Fihdi/QPOL/QPOL-B-Board-BOM.csv

Reference | Qty | Value | Footprint
C2,C3,C9,C10,C14 | 5 | 1n | Capacitor_SMD:C_0805_2012Metric
C6,C11,C12,C13,C15,C16 | 6 | 100n | Capacitor_SMD:C_0805_2012Metric
C7,C8,C17 | 3 | 1u | Capacitor_SMD:C_0805_2012Metric
D1,D15 | 2 | 1N4148 | Diode_SMD:D_SOD-323_HandSoldering
D5,D6 | 2 | LED | LED_THT:LED_D3.0mm
J1,J5 | 2 | Conn_01x10_Pin | Connector_PinHeader_2.54mm:PinHeader_1x10_P2.54mm_Vertical
J2,J3 | 2 | Conn_01x03_Pin | Connector_PinHeader_2.54mm:PinHeader_1x03_P2.54mm_Vertical
J4,J6,J9,J10,J11 | 5 | AudioJack2 | Library:MonoTRS
J15 | 1 | Conn_02x05_Odd_Even | Connector_IDC:IDC-Header_2x05_P2.54mm_Vertical
Q2 | 1 | BC857 | Package_TO_SOT_SMD:SOT-23
R20,R25,R29,R31,R37,R38,R42,R43,R46,R47,R49,R53,R54,R56 | 14 | 1k | Resistor_SMD:R_0805_2012Metric
R22,R23,R24,R27,R28,R30,R32,R33,R34,R35,R36,R39,R40,R41,R45,R48,R50,R51,R52,R55,R57,R58,R59,R60,R61,R63,R64,R66,R67 | 29 | 100k | Resistor_SMD:R_0805_2012Metric
R26,R65 | 2 | 4k7 | Resistor_SMD:R_0805_2012Metric
R44 | 1 | 10k | Resistor_SMD:R_0805_2012Metric
R62 | 1 | 22k | Resistor_SMD:R_0805_2012Metric
RV4,RV5,RV6,RV7 | 4 | 100k | Potentiometer_THT:Potentiometer_Alpha_RD901F-40-00D_Single_Vertical
SW1 | 1 | SW_SPDT | Library:Switch
U1,U2,U5 | 3 | TL074 | Package_SO:TSSOP-14_4.4x5mm_P0.65mm
U3,U4 | 2 | LM13700 | Package_SO:SOIC-16_3.9x9.9mm_P1.27mm
U6 | 1 | TL072 | Package_SO:SOIC-8_3.9x4.9mm_P1.27mm
