Fihdi/QPOL/QPOL-B-Board-BOM.xlsx

 |  |  | QPOL B-Board BOM
Item # | *Designator | *Qty | Manufacturer | *Mfg Part # | Description / Value | *Package/Footprint | Type | Your Instructions / Notes
1 | C2,C3,C9,C10,C14 | 5 |  | C94121 | 1n | Capacitor_SMD:C_0805_2012Metric
2 | C6,C11,C12,C13,C15,C16 | 6 |  | C49678 | 100n | Capacitor_SMD:C_0805_2012Metric
3 | C7,C8,C17 | 3 |  | C28323 | 1u | Capacitor_SMD:C_0805_2012Metric
4 | D1,D15 | 2 |  | C917117 | 1N4148 | Diode_SMD:D_SOD-323_HandSoldering
5 | D5,D6 | 2 |  |  | LED | LED_THT:LED_D3.0mm |  | DNP
6 | J1,J5 | 2 |  |  | Conn_01x10_Pin | Connector_PinHeader_2.54mm:PinHeader_1x10_P2.54mm_Vertical |  | DNP
7 | J2,J3 | 2 |  |  | Conn_01x03_Pin | Connector_PinHeader_2.54mm:PinHeader_1x03_P2.54mm_Vertical |  | DNP
8 | J4,J6,J9,J10,J11 | 5 |  |  | AudioJack2 | Library:MonoTRS |  | DNP
9 | J15 | 1 |  |  | Conn_02x05_Odd_Even | Connector_IDC:IDC-Header_2x05_P2.54mm_Vertical |  | DNP
10 | Q2 | 1 |  | C148244 | BC857 | Package_TO_SOT_SMD:SOT-23
11 | R20,R25,R29,R31,R37,R38,R42,R43,R46,R47,R49,R53,R54,R56 | 14 |  | C95781 | 1k | Resistor_SMD:R_0805_2012Metric
12 | R22,R23,R24,R27,R28,R30,R32,R33,R34,R35,R36,R39,R40,R41,R45,R48,R50,R51,R52,R55,R57,R58,R59,R60,R61,R63,R64,R66,R67 | 29 |  | C2907217 | 100k | Resistor_SMD:R_0805_2012Metric
13 | R26,R65 | 2 |  | C2907326 | 4k7 | Resistor_SMD:R_0805_2012Metric
14 | R44 | 1 |  | C17414 | 10k | Resistor_SMD:R_0805_2012Metric
15 | R62 | 1 |  | C17560 | 22k | Resistor_SMD:R_0805_2012Metric
16 | RV4,RV5,RV6,RV7 | 4 |  |  | 100k | Potentiometer_THT:Potentiometer_Alpha_RD901F-40-00D_Single_Vertical |  | DNP
17 | SW1 | 1 |  |  | SW_SPDT | Library:Switch |  | DNP
18 | U1,U2,U5 | 3 |  | C4370424 | TL074 | Package_SO:TSSOP-14_4.4x5mm_P0.65mm
19 | U3,U4 | 2 |  | C174050 | LM13700 | Package_SO:SOIC-16_3.9x9.9mm_P1.27mm
20 | U6 | 1 |  | C67473 | TL072 | Package_SO:SOIC-8_3.9x4.9mm_P1.27mm
