Fihdi/QPOL/QPOL-Schematic.pdf

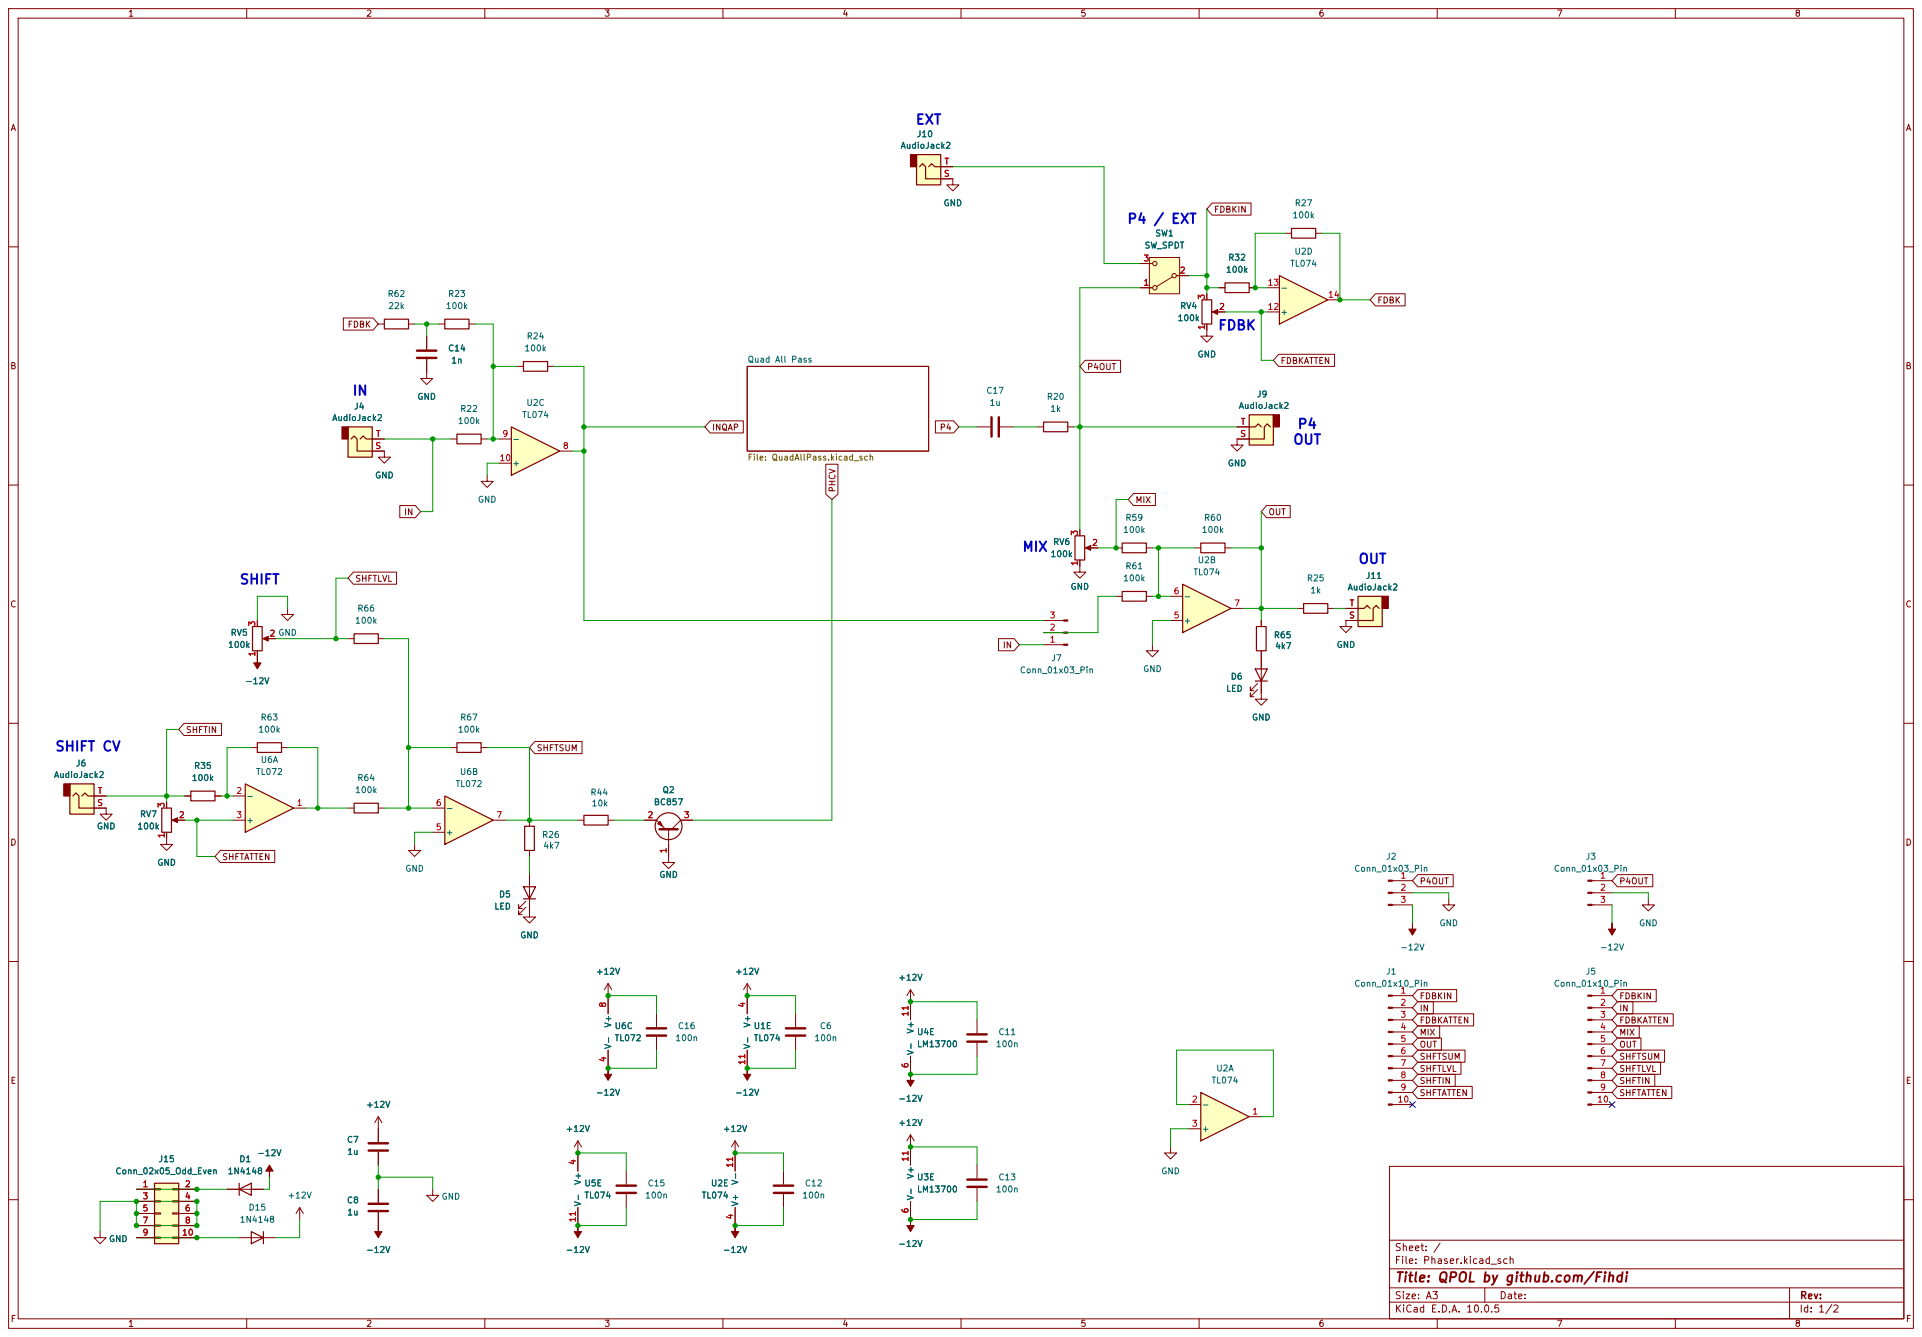
[picture p3: page 1]

5 5 | 6 6
7 7 | 8 8

Sheet: /
File: Phaser.kicad_sch
Title: QPOL by github.com/Fihdi

Size: A3 | Rev: | F Date:
KiCad E.D.A. 10.0.5 | Id: 1/2

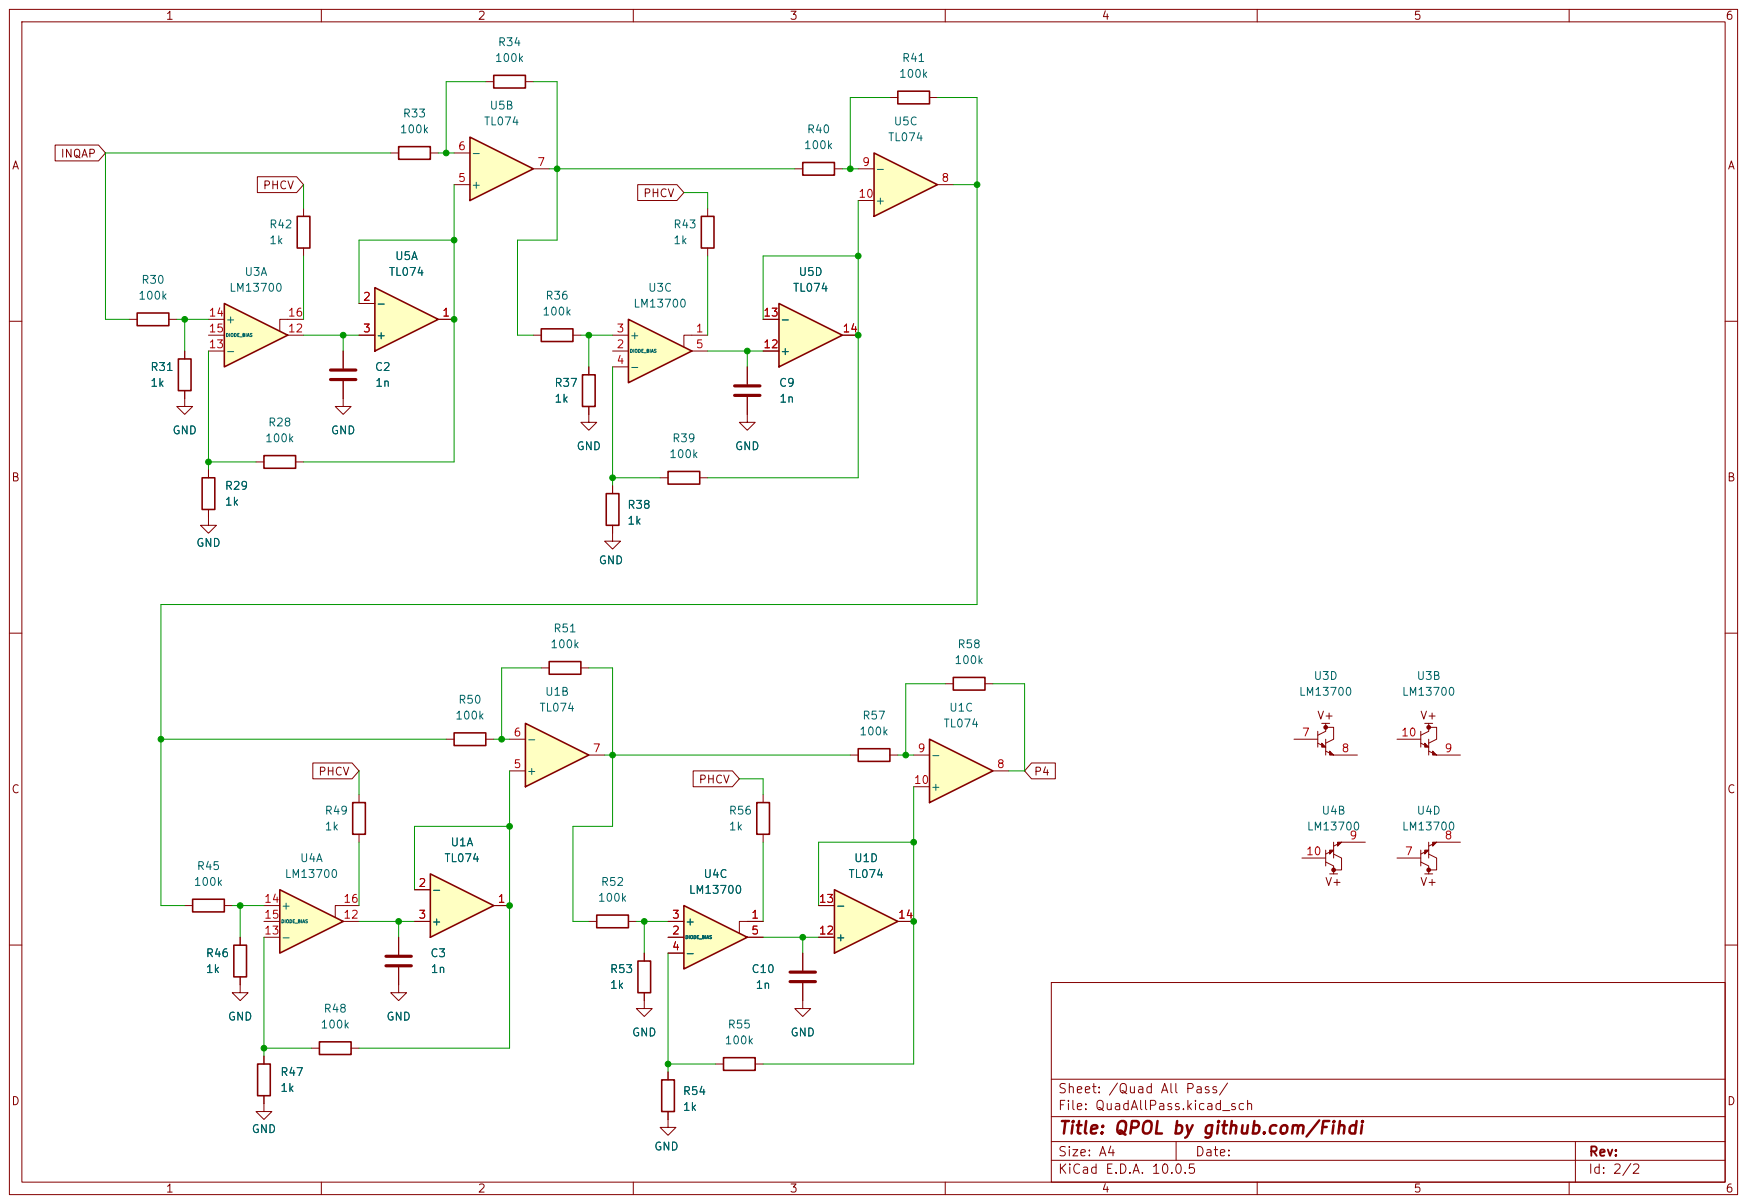
[picture p4: page 2]

Sheet: /Quad All Pass/
File: QuadAllPass.kicad_sch
Title: QPOL by github.com/Fihdi

Size: A4 | Rev:
KiCad E.D.A. 10.0.5 | Id: 2/2
