Fihdi/QPOL/QPOL.kicad_pcb

## KiCad design QPOL.kicad_pcb (2026-10-20)

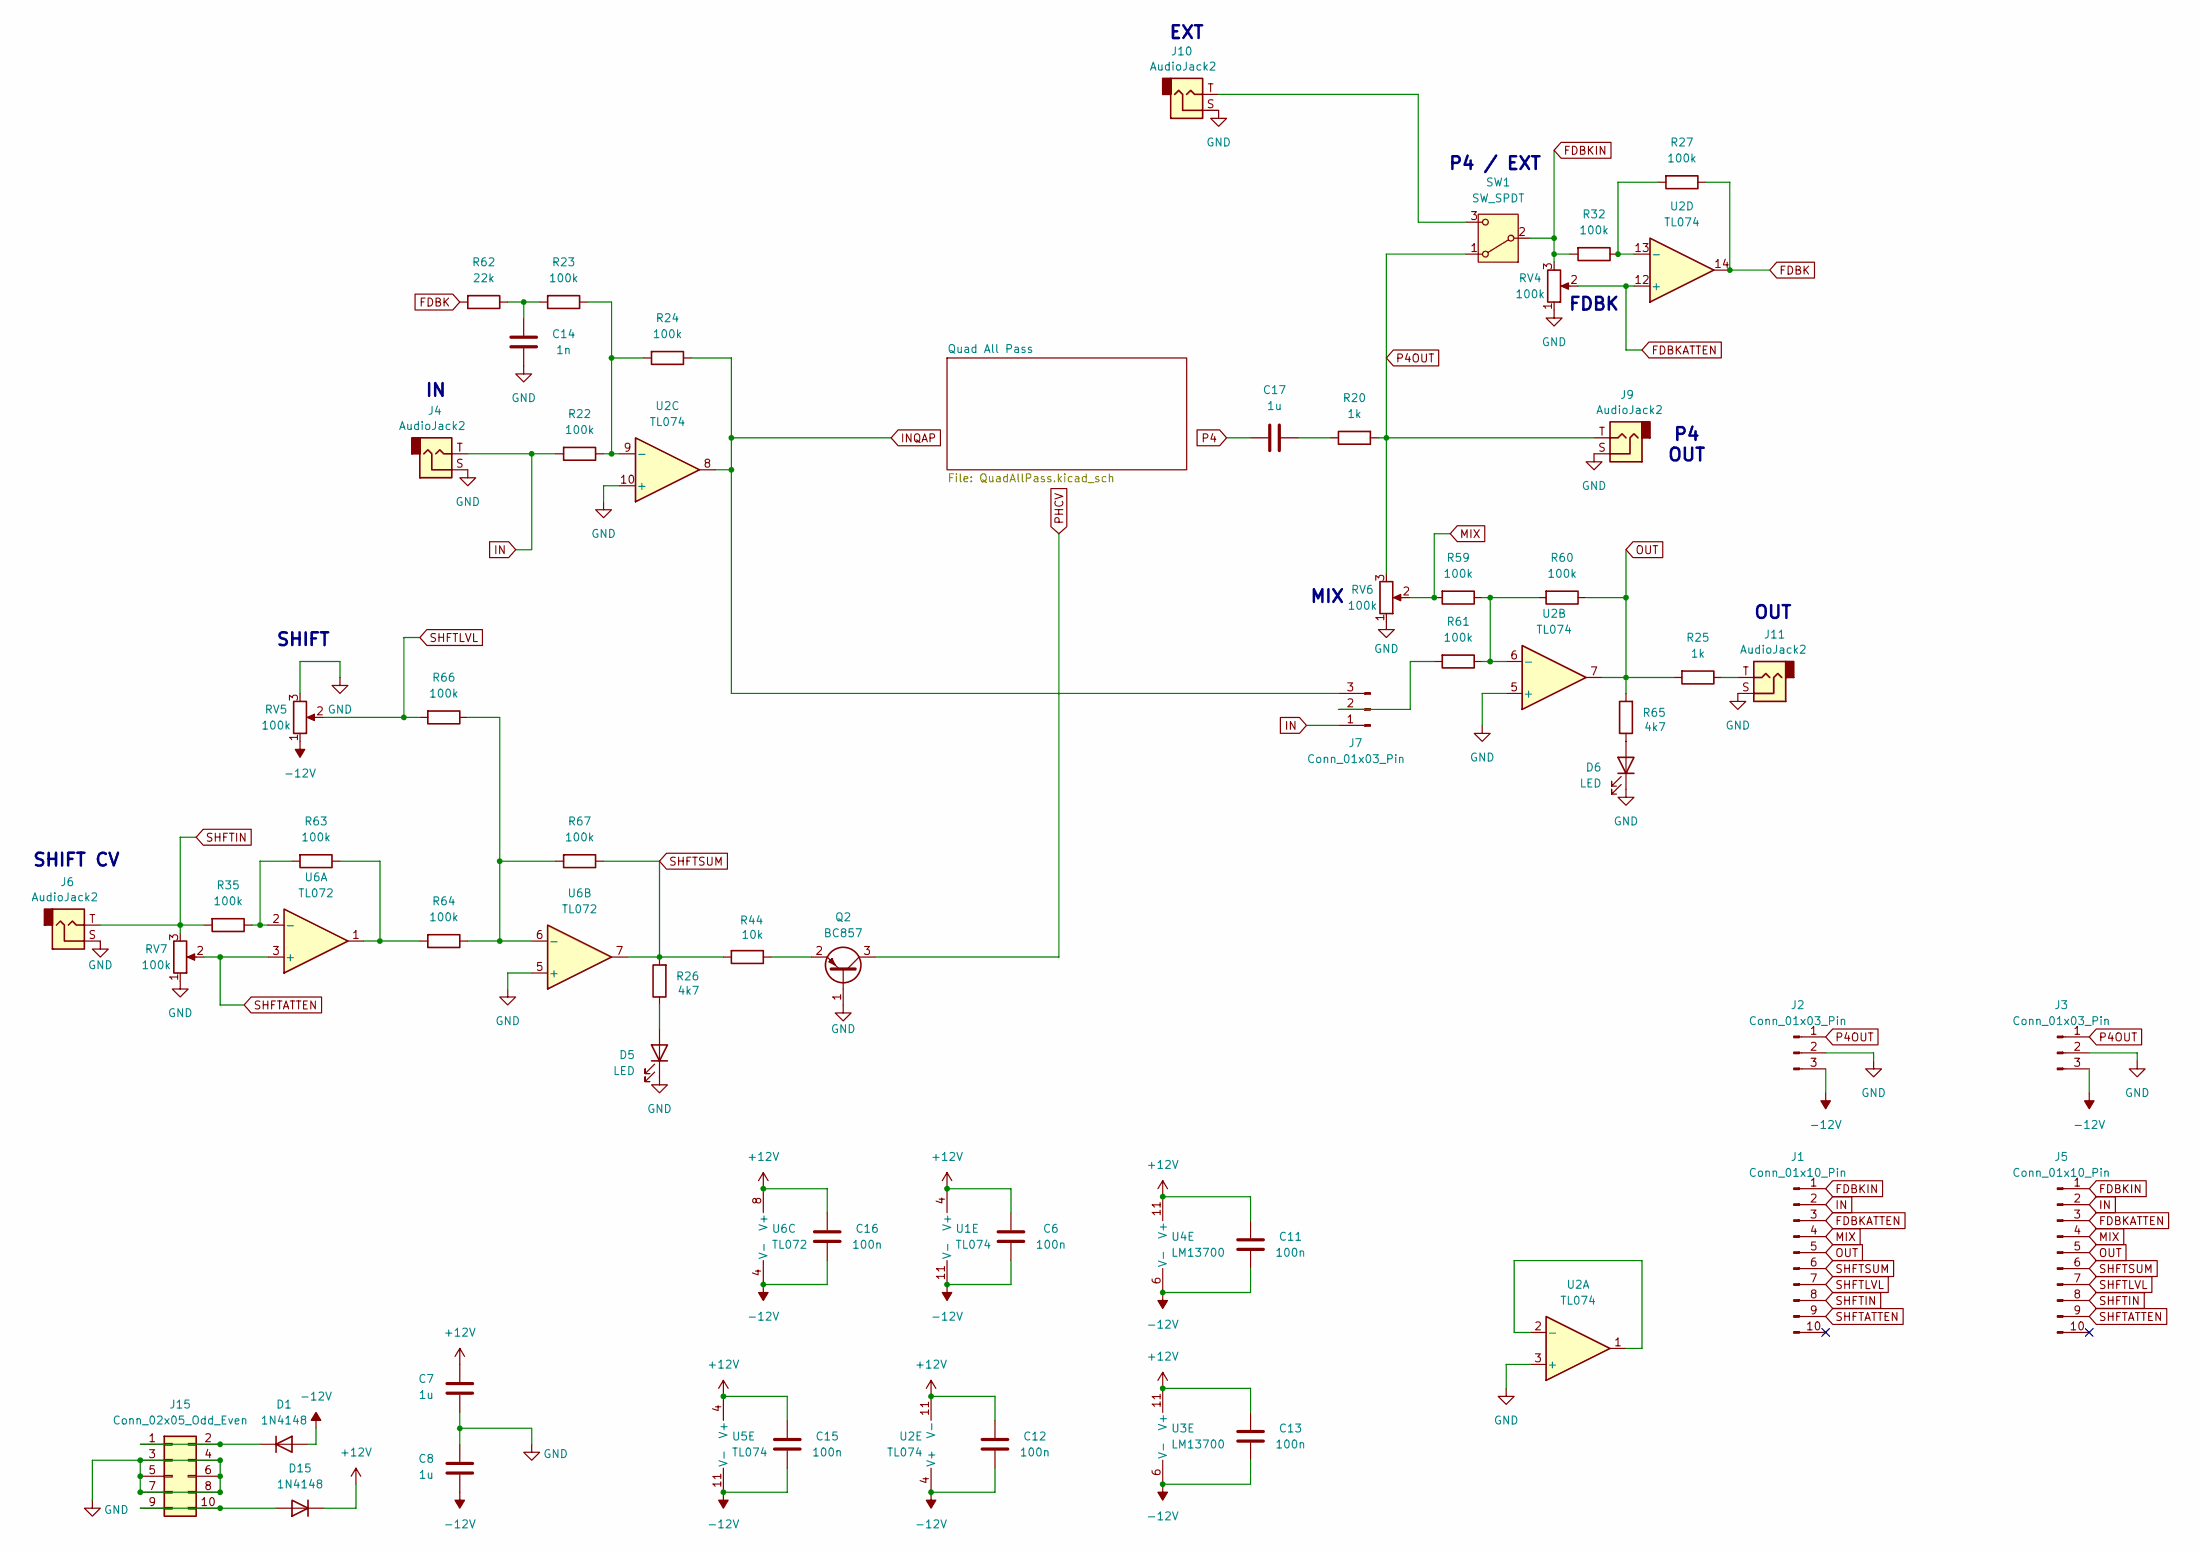
[picture p5: schematic QPOL.kicad_sch, QPOL by github.com/Fihdi]

Parts:
C6, C11, C12, C13, C15, C16: 100n; C_0805_2012Metric
C7, C8, C17: 1u; C_0805_2012Metric
C14: 1n; C_0805_2012Metric
D1, D15: 1N4148; D_SOD-323_HandSoldering
D5, D6: LED; LED_D3.0mm
J1, J5: Conn_01x10_Pin; PinHeader_1x10_P2.54mm_Vertical
J2, J3: Conn_01x03_Pin; PinHeader_1x03_P2.54mm_Vertical
J4, J6, J9, J10, J11: AudioJack2; MonoTRS
J7: Conn_01x03_Pin; PinSocket_1x03_P2.54mm_Vertical
J15: Conn_02x05_Odd_Even; IDC-Header_2x05_P2.54mm_Vertical
Q2: BC857; SOT-23
R20, R25: 1k; R_0805_2012Metric
R22, R23, R24, R27, R32, R35, R59, R60, R61, R63, R64, R66, R67: 100k; R_0805_2012Metric
R26, R65: 4k7; R_0805_2012Metric
R44: 10k; R_0805_2012Metric
R62: 22k; R_0805_2012Metric
RV4, RV5, RV6, RV7: 100k; Potentiometer_Alpha_RD901F-40-00D_Single_Vertical
SW1: SW_SPDT; Switch
U1, U2, U5: TL074; TSSOP-14_4.4x5mm_P0.65mm
U3, U4: LM13700; SOIC-16_3.9x9.9mm_P1.27mm
U6: TL072; SOIC-8_3.9x4.9mm_P1.27mm

Connections:
+12V: C6.1, C7.1, C11.1, C12.1, C13.1, C15.1, C16.1, D15.1 (K), U1.4 (V+), U2.11 (V-), U3.11 (V+), U4.11 (V+), U5.4 (V+), U6.8 (V+)
-12V: C6.2, C8.2, C11.2, C12.2, C13.2, C15.2, C16.2, D1.2 (A), J2.3, J3.3, RV5.1, U1.11 (V-), U2.4 (V+), U3.6 (V-), U4.6 (V-), U5.11 (V-), U6.4 (V-)
FDBK: R27.1, R62.2, U2.14
FDBKATTEN: J1.3, J5.3, RV4.2, U2.12 (+)
FDBKIN: J1.1, J5.1, R32.2, RV4.3, SW1.2 (B)
GND: C7.2, C8.1, C14.2, D5.1 (K), D6.1 (K), J2.2, J3.2, J4.S, J6.S, J9.S, J10.S, J11.S, J15.3, J15.4, J15.5, J15.6, J15.7, J15.8, Q2.1 (B), RV4.1, RV5.3, RV6.1, RV7.1, U2.3 (+), U2.5 (+), U2.10 (+), U6.5 (+); also elsewhere on the board
IN: J1.2, J4.T, J5.2, J7.1, R22.2
INQAP: J7.3, R24.1, U2.8; also elsewhere on the board
MIX: J1.4, J5.4, R59.2, RV6.2
unnamed: C14.1, R23.2, R62.1
unnamed: C17.2, R20.1
unnamed: D1.1 (K), J15.1, J15.2
unnamed: D5.2 (A), R26.1
unnamed: D6.2 (A), R65.1
unnamed: D15.2 (A), J15.9, J15.10
unnamed: J7.2, R61.2
unnamed: J11.T, R25.1
unnamed: Q2.2 (E), R44.1
unnamed: R63.1, R64.2, U6.1
unnamed: J10.T, SW1.3 (C)
unnamed: U2.1, U2.2 (-)
unnamed: R59.1, R60.2, R61.1, U2.6 (-)
unnamed: R22.1, R23.1, R24.2, U2.9 (-)
unnamed: R27.2, R32.1, U2.13 (-)
unnamed: R35.1, R63.2, U6.2 (-)
unnamed: R64.1, R66.1, R67.2, U6.6 (-)
OUT: J1.5, J5.5, R25.2, R60.1, R65.2, U2.7
P4: C17.1; also elsewhere on the board
P4OUT: J2.1, J3.1, J9.T, R20.2, RV6.3, SW1.1 (A)
PHCV: Q2.3 (C); also elsewhere on the board
SHFTATTEN: J1.9, J5.9, RV7.2, U6.3 (+)
SHFTIN: J1.8, J5.8, J6.T, R35.2, RV7.3
SHFTLVL: J1.7, J5.7, R66.2, RV5.2
SHFTSUM: J1.6, J5.6, R26.2, R44.2, R67.1, U6.7

Notes on the sheet:
OUT
FDBK
SHIFT
SHIFT CV
EXT
MIX
P4 OUT
P4 / EXT

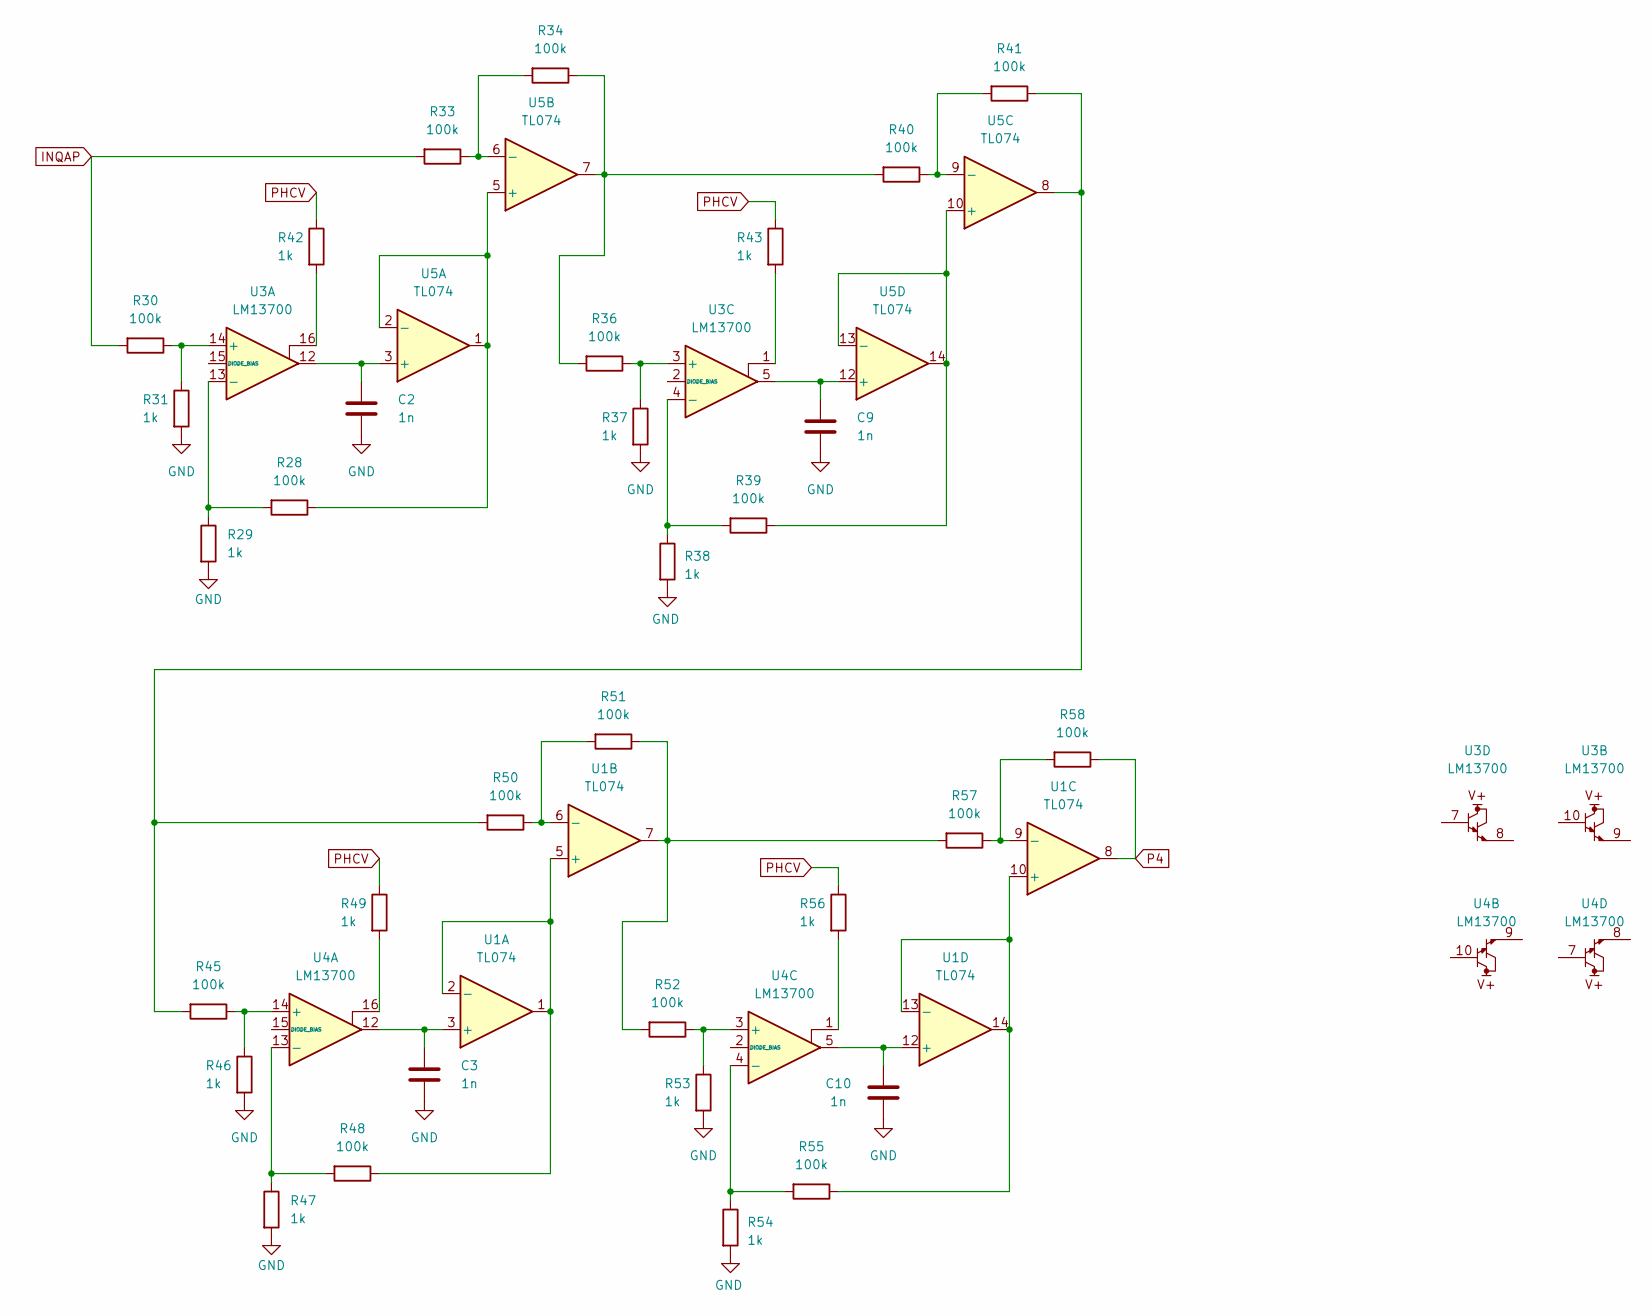
[picture p6: schematic QuadAllPass.kicad_sch, QPOL by github.com/Fihdi]

Parts:
C2, C3, C9, C10: 1n; C_0805_2012Metric
R28, R30, R33, R34, R36, R39, R40, R41, R45, R48, R50, R51, R52, R55, R57, R58: 100k; R_0805_2012Metric
R29, R31, R37, R38, R42, R43, R46, R47, R49, R53, R54, R56: 1k; R_0805_2012Metric
U1, U5: TL074; TSSOP-14_4.4x5mm_P0.65mm
U3, U4: LM13700; SOIC-16_3.9x9.9mm_P1.27mm

Connections:
GND: C2.2, C3.2, C9.2, C10.2, R29.2, R31.2, R37.2, R38.2, R46.2, R47.2, R53.2, R54.2; also elsewhere on the board
INQAP: R30.2, R33.2; also elsewhere on the board
unnamed: R34.1, R36.2, R40.2, U5.7
unnamed: R41.1, R45.2, R50.2, U5.8
unnamed: R42.2, U3.16
unnamed: R43.2, U3.1
unnamed: R49.2, U4.16
unnamed: R51.1, R52.2, R57.2, U1.7
unnamed: R56.2, U4.1
unnamed: C3.1, U1.3 (+), U4.12
unnamed: R48.1, U1.1, U1.2 (-), U1.5 (+)
unnamed: R50.1, R51.2, U1.6 (-)
unnamed: R55.1, U1.10 (+), U1.13 (-), U1.14
unnamed: R57.1, R58.2, U1.9 (-)
unnamed: C10.1, U1.12 (+), U4.5
unnamed: R30.1, R31.1, U3.14 (+)
unnamed: R28.2, R29.1, U3.13 (-)
unnamed: R36.1, R37.1, U3.3 (+)
unnamed: R38.1, R39.2, U3.4 (-)
unnamed: R45.1, R46.1, U4.14 (+)
unnamed: R47.1, R48.2, U4.13 (-)
unnamed: R52.1, R53.1, U4.3 (+)
unnamed: R54.1, R55.2, U4.4 (-)
unnamed: C2.1, U3.12, U5.3 (+)
unnamed: R28.1, U5.1, U5.2 (-), U5.5 (+)
unnamed: R33.1, R34.2, U5.6 (-)
unnamed: R39.1, U5.10 (+), U5.13 (-), U5.14
unnamed: R40.1, R41.2, U5.9 (-)
unnamed: C9.1, U3.5, U5.12 (+)
P4: R58.1, U1.8; also elsewhere on the board
PHCV: R42.1, R43.1, R49.1, R56.1; also elsewhere on the board

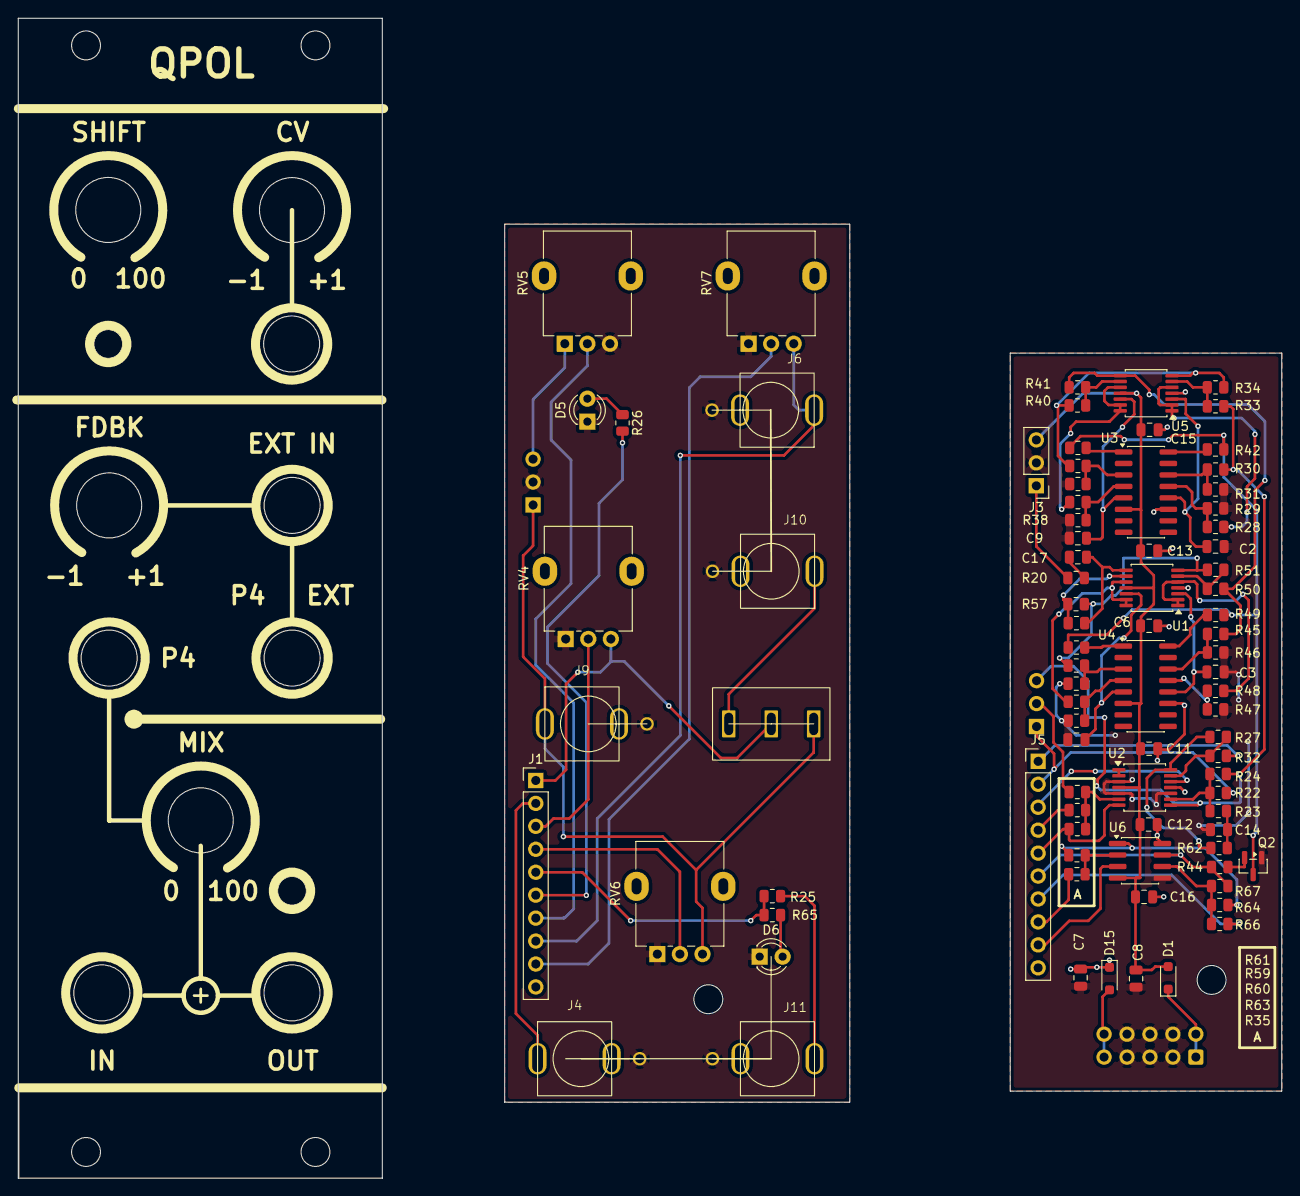
[picture p7: board QPOL.kicad_pcb from above]

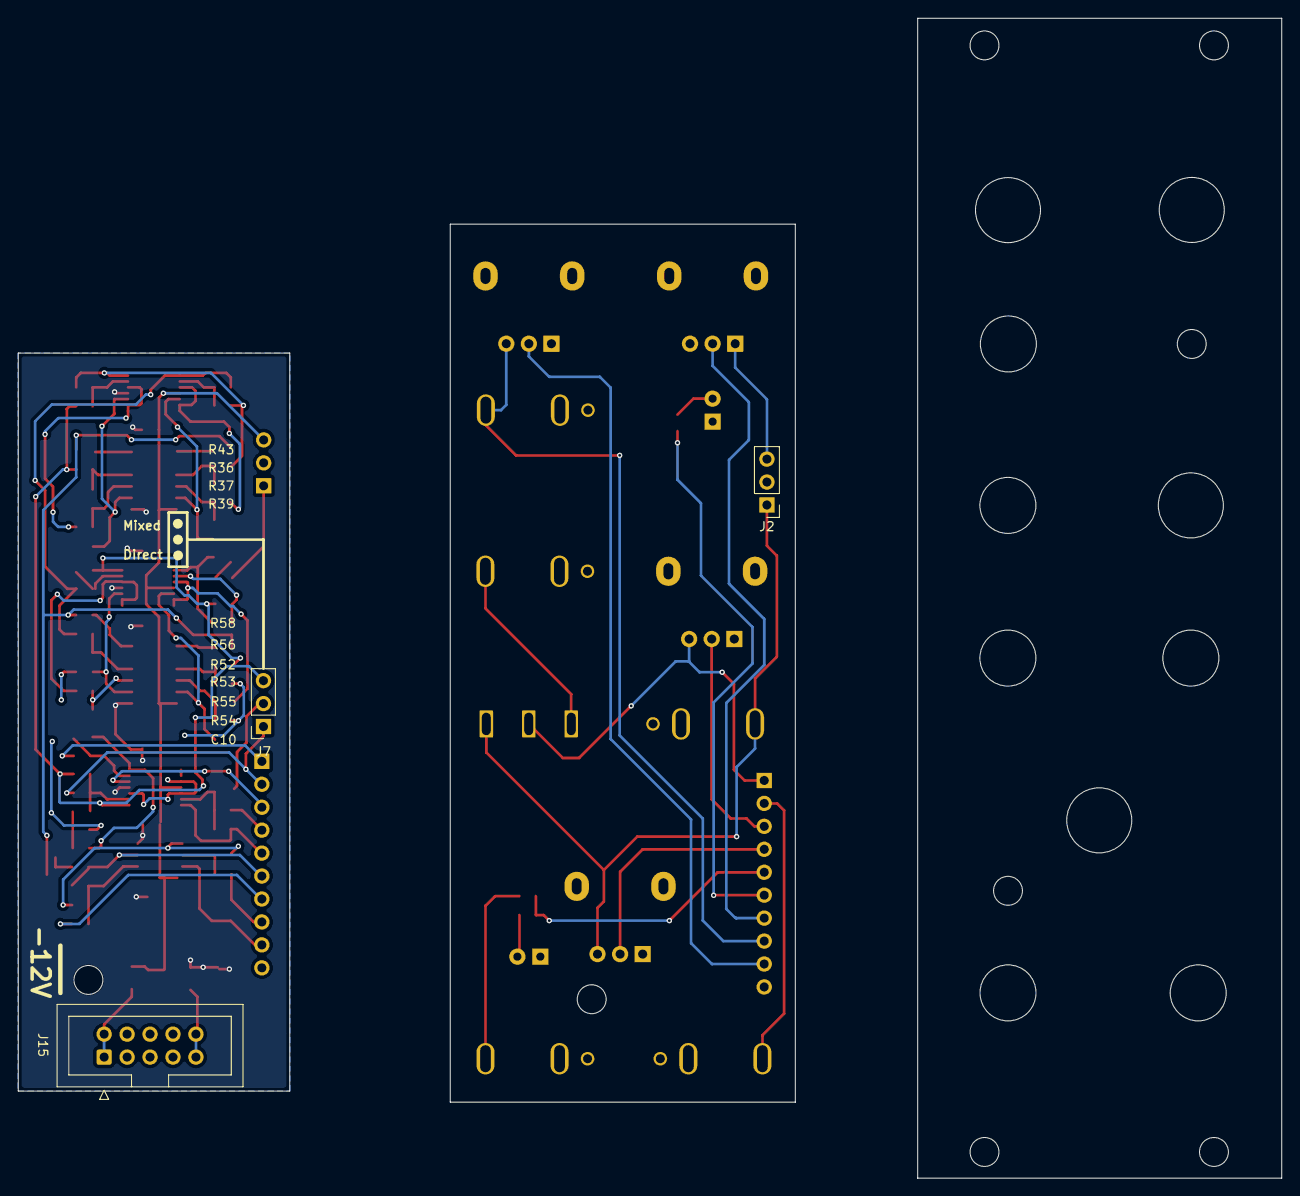
[picture p8: board QPOL.kicad_pcb from below]

Board: 2 copper layers, 30.1 x 81.7 mm, 88 parts (3 on the bottom side), 61 nets.
